adamalfath/sentsor-core-esp07s/example/sentsor-core07s_4-vbatsense/README.md

Description: Measure voltage from JST-PH connector/VBAT pin
