adamalfath/sentsor-core-esp07s/media/core07s-extra0.png

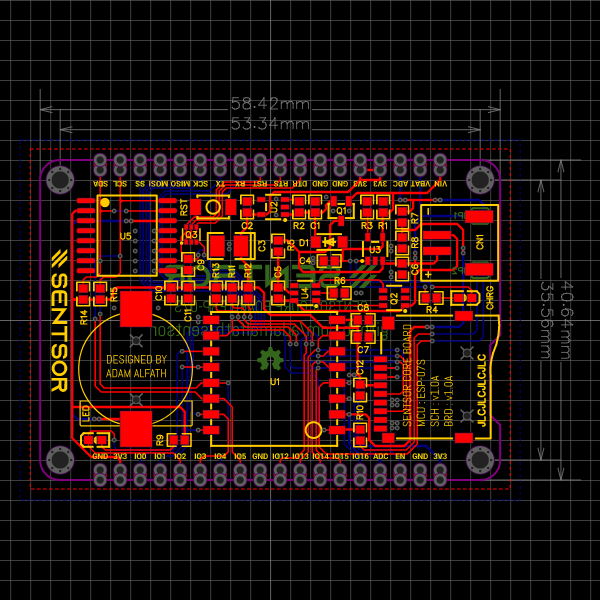
media/core07s-extra0.png
