adamalfath/sentsor-core-esp07s/media/core07s-extra1.png

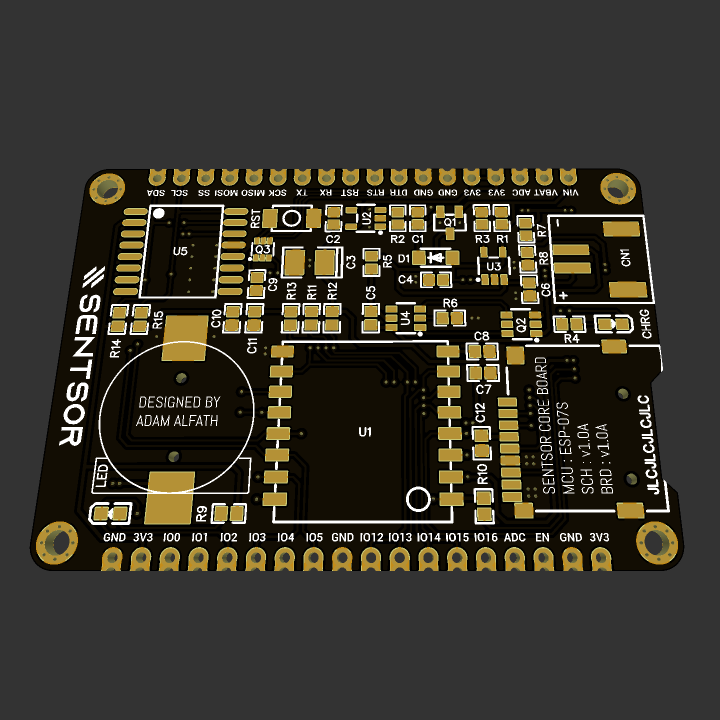
media/core07s-extra1.png
