adamalfath/sentsor-core-esp07s/media/core07s-extra2.png

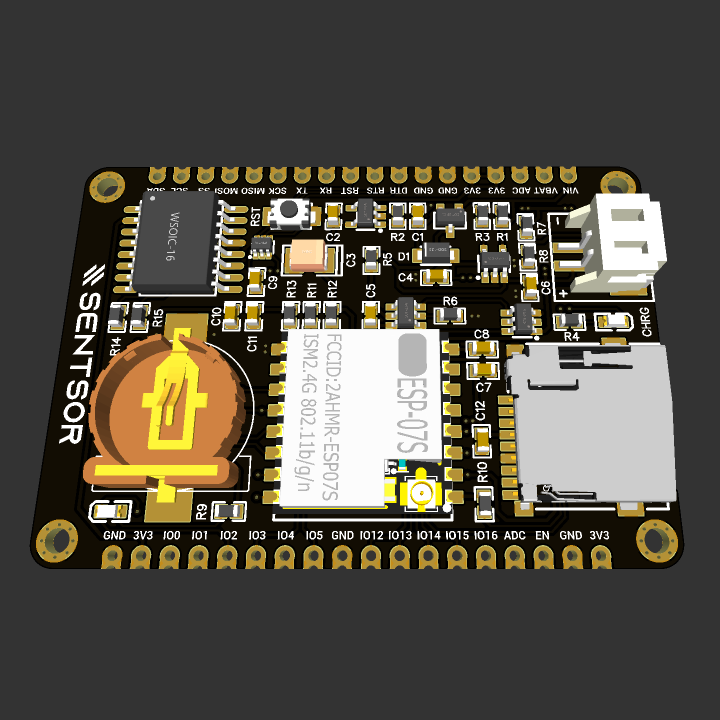
media/core07s-extra2.png
