adamalfath/sentsor-core-esp07s/media/core07s-extra3.jpg

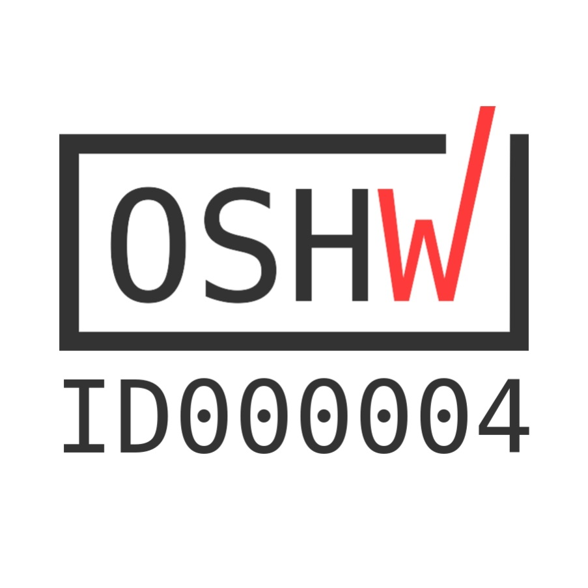
media/core07s-extra3.jpg
