adamalfath/sentsor-core-esp07s/media/core07s-extra4.jpg

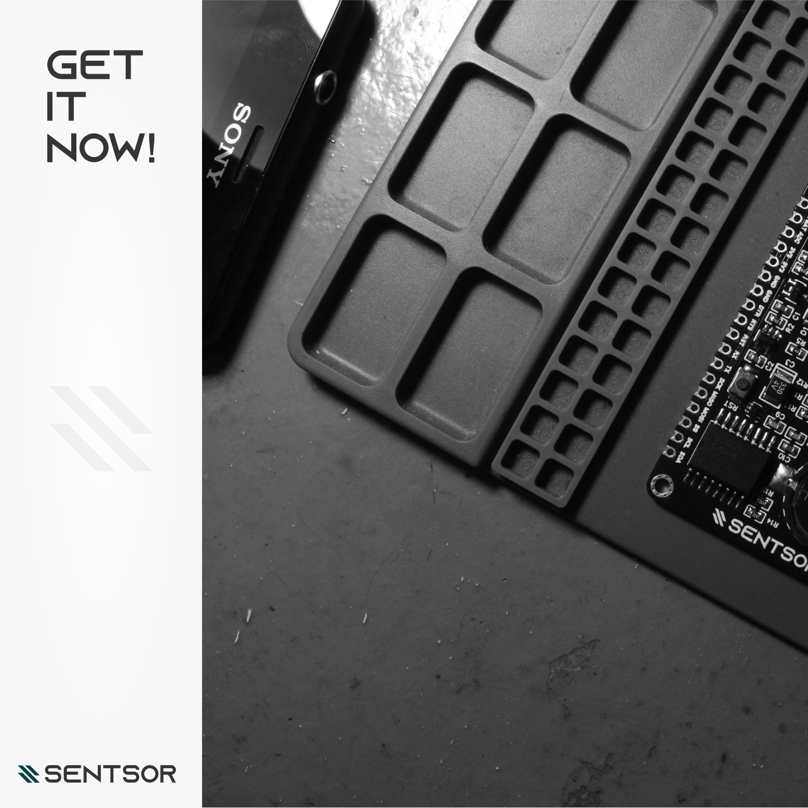
media/core07s-extra4.jpg
