adamalfath/sentsor-core-esp07s/media/core07s-extra5.jpg

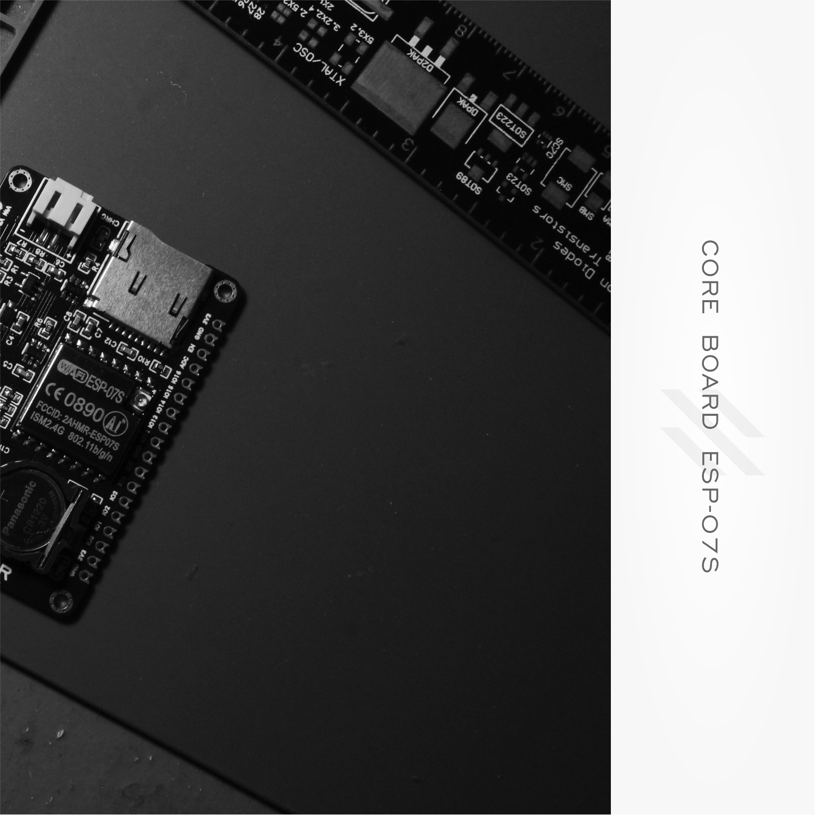
media/core07s-extra5.jpg
