adamalfath/sentsor-core-esp07s/media/OSHW_mark_ID000004.png

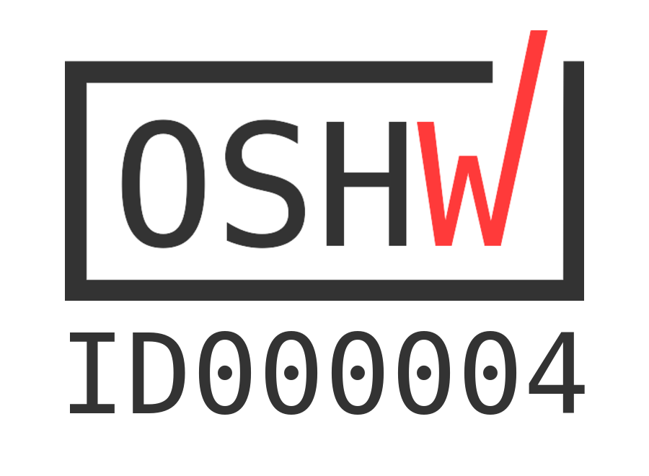
media/OSHW_mark_ID000004.png
