adamalfath/sentsor-core-esp07s/media/sq/core07s-img0sq.jpg

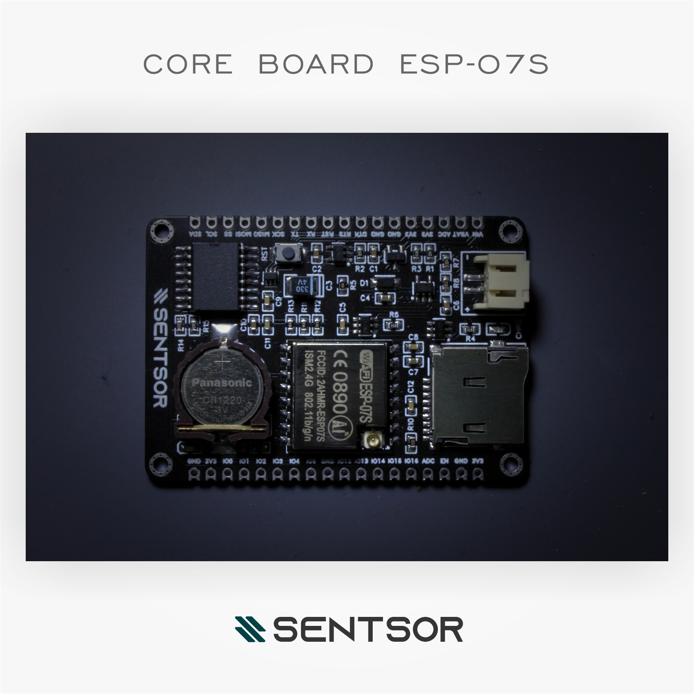
media/sq/core07s-img0sq.jpg
