adamalfath/sentsor-core-esp07s/media/sq/core07s-img1sq.jpg

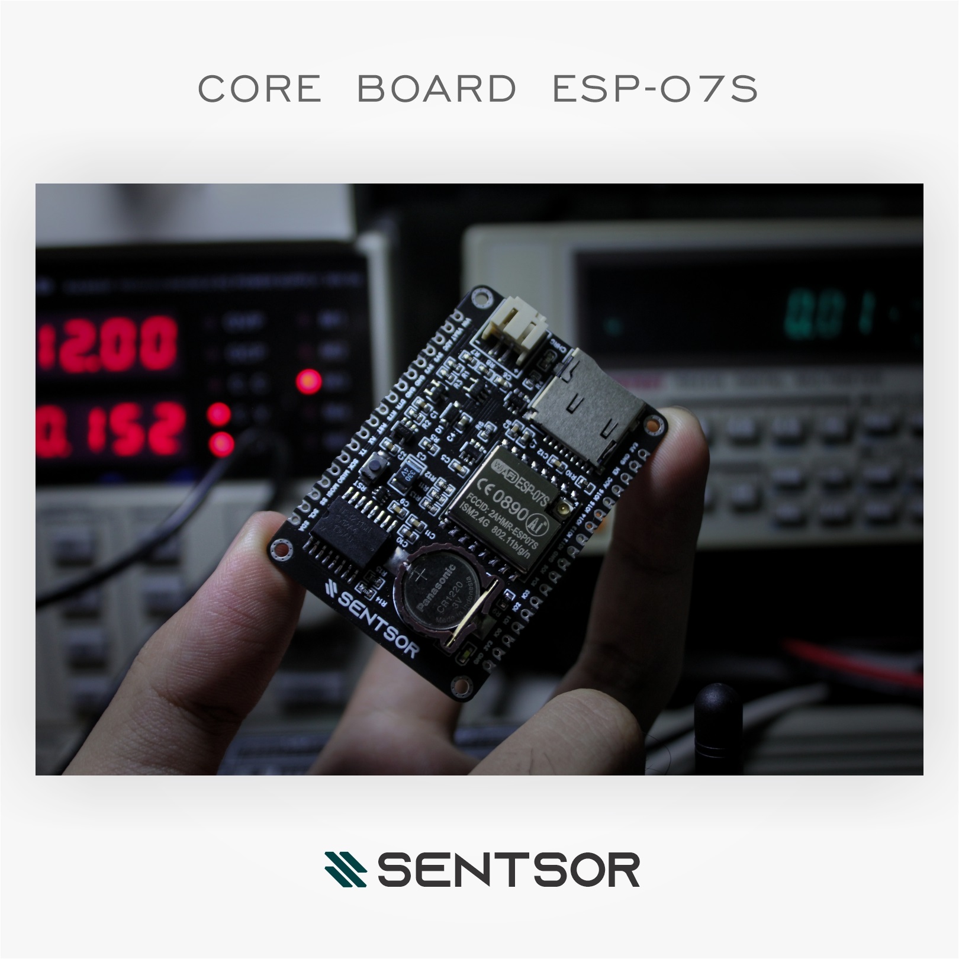
media/sq/core07s-img1sq.jpg
