adamalfath/sentsor-core-esp07s/media/sq/core07s-img2sq.jpg

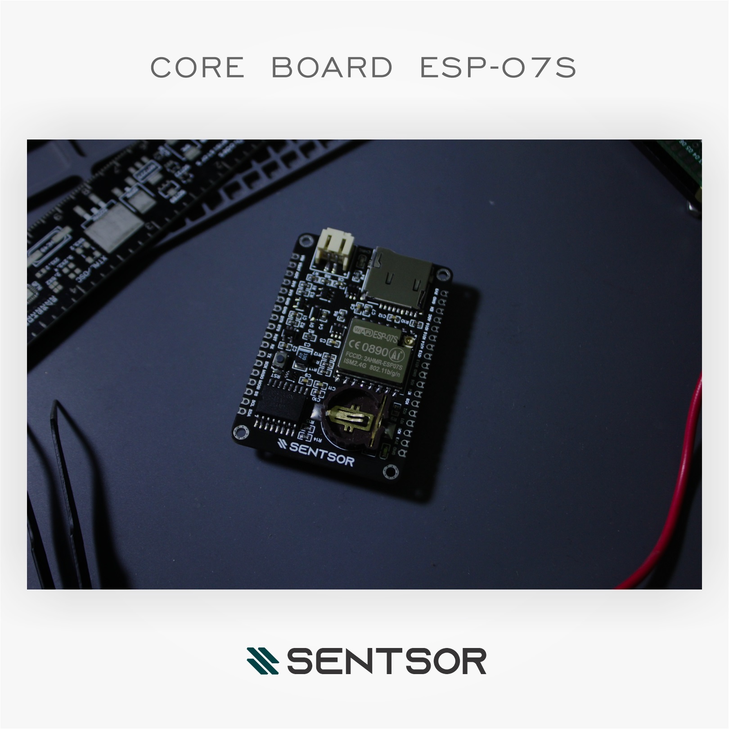
media/sq/core07s-img2sq.jpg
