adamalfath/sentsor-core-esp07s/media/sq/core07s-img3sq.jpg

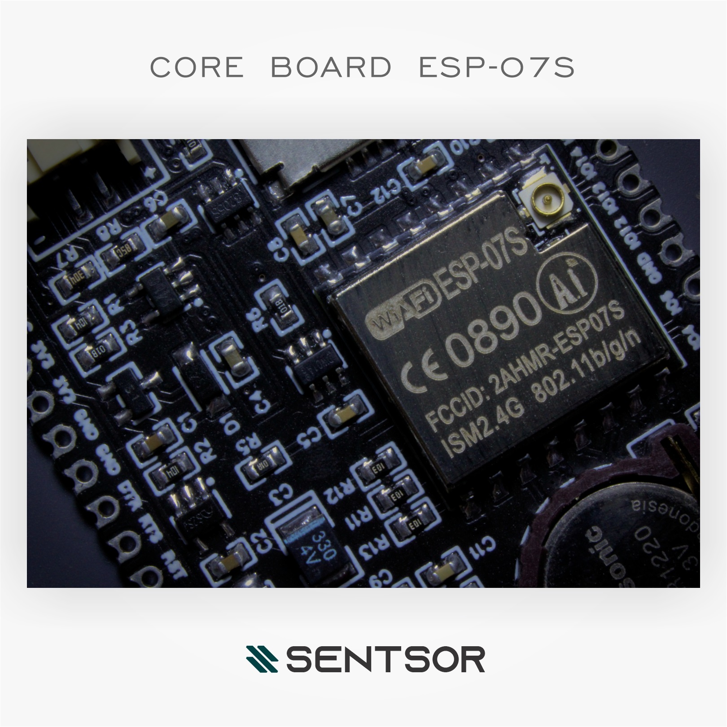
media/sq/core07s-img3sq.jpg
