adamalfath/sentsor-core-esp07s/media/sq/core07s-img4sq.jpg

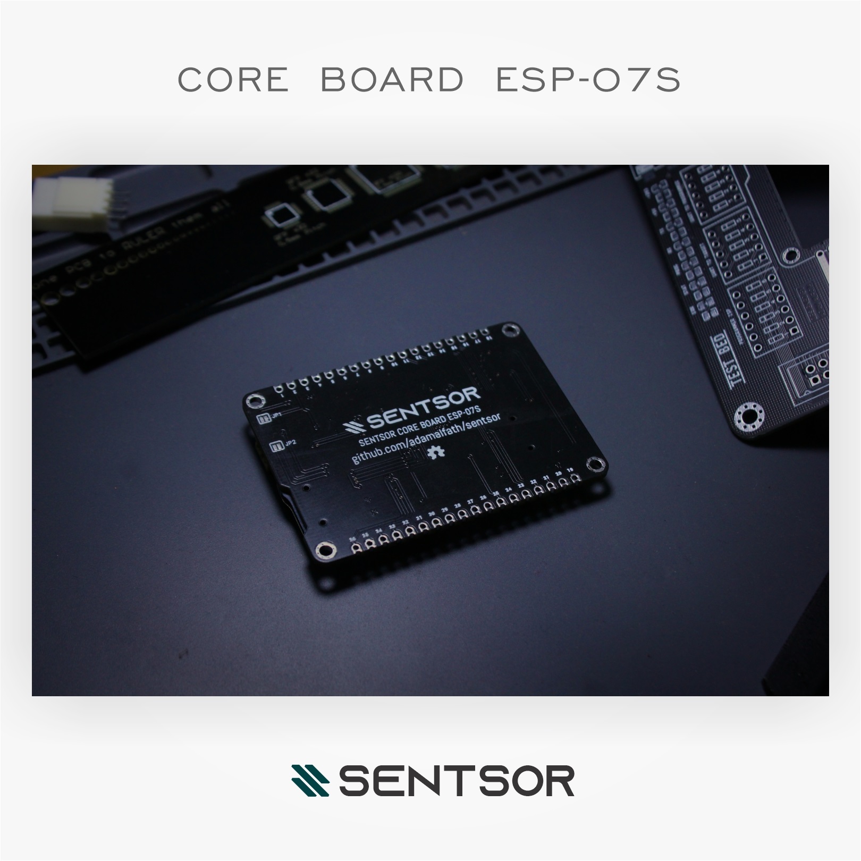
media/sq/core07s-img4sq.jpg
