adamalfath/sentsor-core-esp07s/Schematic_SENTSOR CORE ESP-07S.pdf

## REGULATOR

## CHARGER & PROTECTION

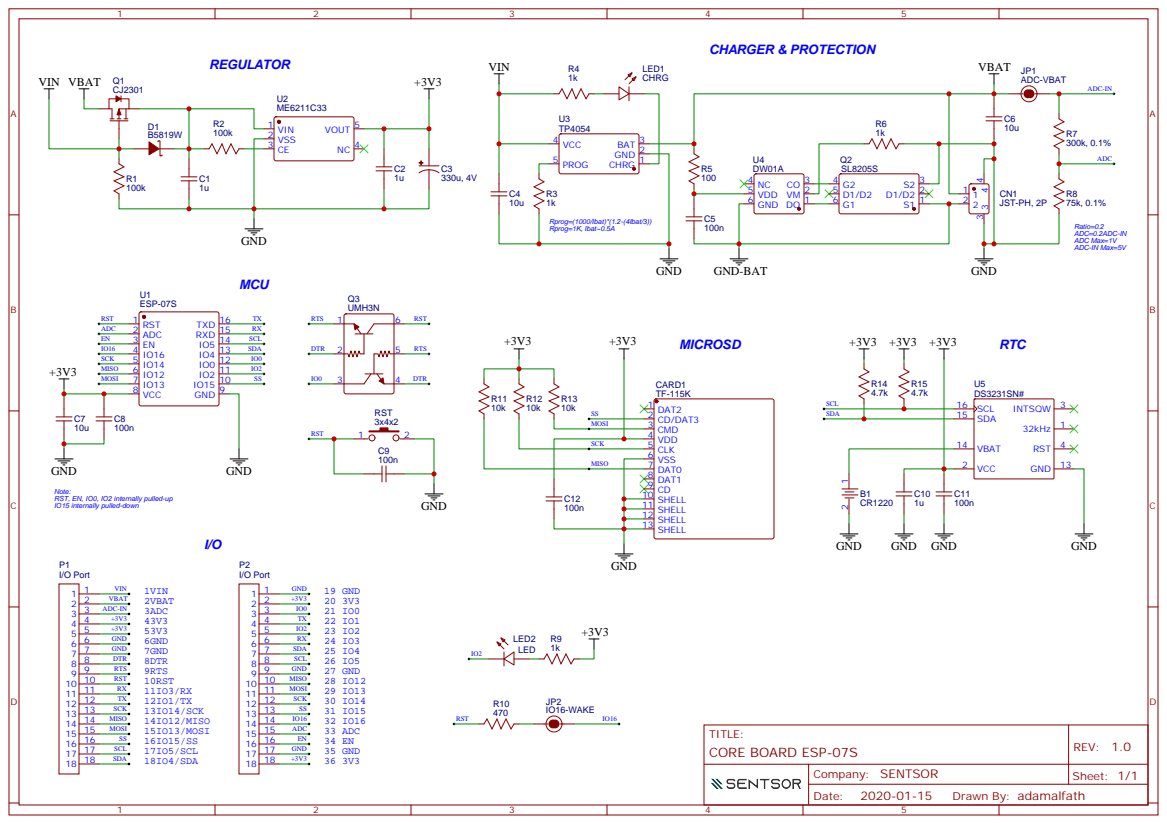
[picture p26: page 1]

Note:
RST, EN, IO0, IO2 internally pulled-up
IO15 internally pulled-down
