adamalfath/sentsor-core-esp07s/(commit log)

2020-07-11 Upload media & schematic
2020-07-11 Add images & BOM
2020-07-15 Fix typo IO number
    [sentsor-core07s_1-selftest.ino]
