adamalfath/sentsor-core-esp07s/(notices)

Notices in the files:
README.md:
CC BY-SA 4.0
